mimimimichel/Joey/tools/joey-pilot/rapports/campagne-2026-10-24-soir/droit-apres.jpg

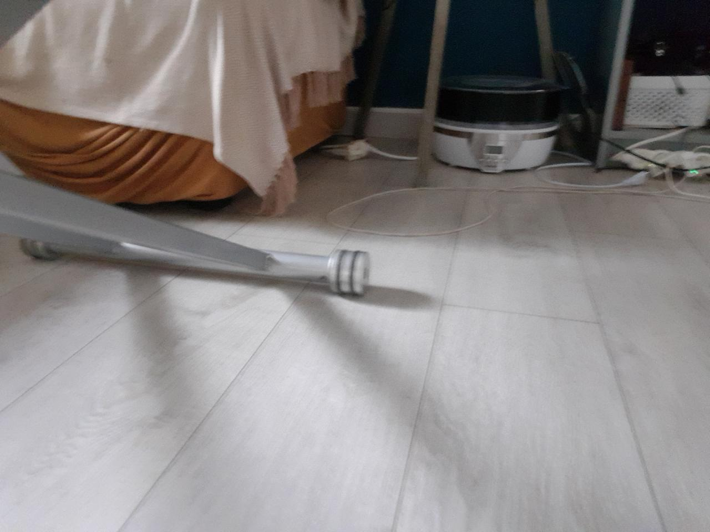
tools/joey-pilot/rapports/campagne-2026-10-24-soir/droit-apres.jpg
