mimimimichel/Joey/tools/joey-pilot/rapports/2026-10-24-1450.md

# Séance du 24/10/2026, midi à 14 h 50 (v0.72 à v0.78)

Téléphone : S8+ (SM-G955F) jusqu'à 14 h 28, puis batterie vide. Suite des essais sur le S10 (SM-G973F).

## Validé sur le robot

- Détecteurs de proximité du Roomba 616 (paquets 45 à 51) : ils marchent. La main à 5 cm fait monter les valeurs.
- Liaison série en 5 V (et non 3,3 V) : plus de coupure au repos sur la base.
- Réouverture automatique du port USB après une coupure : marche (essai toutes les 10 s, 30 fois).
- Accostage par le Roomba lui-même : réussi une fois.
- Pastilles blanches du corps : visibles de -50° à -70° d'inclinaison de la tête. Sur les images de test, l'angle
  tête/corps est mesuré à 8° près environ.

## Problèmes vus, et corrections

| Problème | Correction | Version |
|---|---|---|
| Une commande tronquée lançait l'aspiration « spot » | reprise de contrôle (start, safe, moteurs coupés) | 0.72 |
| Faux appui sur le bouton DOCK | anti-rebond (deux lectures), ignoré en mode test | 0.76 |
| Aligner la tête en bougeant la nacelle oscillait (dépassements) | c'est le corps qui tourne vers la tête | 0.76 |
| Pastilles hors de vue quand la tête est loin de l'axe | recherche en tournant le corps de 60° | 0.77 |
| Liaison morte 8 s sans réponse | réouverture du port USB | 0.77 |
| Point d'approche de la base du mauvais côté | signe corrigé | 0.70 |

## Encore à valider sur le robot

- Alignement tête/corps par les pastilles avec le corps qui tourne (0.77) : pas essayé, le S8+ s'est éteint juste avant.
- La liaison se coupe encore au moment où le Roomba quitte sa base (piste : faux contact du câble mini-DIN).
- Le fil de réveil (BRC, broche 5) ne réveille pas le Roomba.
- Profondeur MiDaS en roulant, passage entre deux chaises, `cmd scan` et `cmd carto`, accostage vérifié, mode autonome.

## Nouveau en 0.78

- Yeux pixelisés : `cmd pixels n=56` (défaut), `n=0` pour des yeux lisses.
- Appui sur l'écran : il lève la tête vers la personne avec un petit sursaut, les roues restent immobiles, et il ne
  part pas en sortie autonome pendant 2 minutes.

## Passage sur le S10

- Joey 0.78 installé (il avait la 0.64), Bluetooth rallumé (il était coupé), adb sur le port fixe 5555.
- `JOEY_PHONE=192.168.0.27:5555,192.168.0.41:5555` dans `~/.config/joey/env` : le pilote vise le S10.
- Mode autonome coupé pour les essais.
- À refaire sur le S10 : test des roues, alignement par les pastilles, carte (la carte du salon est sur le S8+).

## Suite, 15 h à 17 h (v0.79 à v0.83, S10 puis S8)

### Trouvé et corrigé
- **Coupures à la sortie de base (cause trouvée)** : ce Roomba (firmware release-stm32v2-v3.9.7) annonce son mode avec
  un cran de plus que la norme (passif 2, sécurité 3, complet 4). Le décodeur rejetait « complet = 4 » comme du bruit :
  la liaison paraissait coupée à chaque sortie de base. Décalage mesuré à la connexion (0.80). Sortie de base en mode
  complet validée sur le robot (15 h 29), accostage validé (10 s depuis 30 cm).
- **Mélodies** : écrire une mélodie rend le Roomba muet ~2 s. Plus jamais en roulant, une toutes les 4 s au plus (0.83).
- **Alignement par les pastilles** : il tournait pour chercher les pastilles après une bonne mesure, ~600° au bord du
  tapis (tapis embarqué). Rotation bornée à 240°, recherche par la tête d'abord (0.81, 0.83).
- **Détecteur de pastilles et S10** : la caméra du S10 est à ~10 cm de l'axe de la nacelle. Les anciens critères
  (droite des pastilles sous la caméra, une seule pastille) donnaient de fausses mesures sur les reflets du mât et les
  fils. Nouveau critère par la forme (pastille de l'anneau allongée en travers de l'axe, bord du Roomba juste après la
  pastille avant, blanc franc). Hors ligne sur 18 images : 5 vraies mesures cohérentes avec les rotations de la nacelle
  (à 2° près), 0 fausse mesure. À valider sur le robot.
- **Relecture indépendante** (9 agents) : octet 7 (ordre reset) dans la requête des capteurs, retiré (lecture par le
  groupe 7-16) ; mur virtuel 162 confondu avec la base ; impulsion de réveil hors de la boucle des capteurs ; recul hors
  de la base arrêtable ; script d'installation (adb avalait la liste des téléphones, double installation).
- Suite complète des tests : 178 tests verts sur la 0.81.

### Fil de réveil
- Câblage confirmé par Michael (RTS -> trou 5). Firmware assez récent pour le réveil sur la base. `cmd brc` (0.82)
  tranchera : trois impulsions après un redémarrage doivent le faire passer à 19 200 bauds.

### En attente
- Le S10 a redémarré vers 16 h 20 (cause inconnue) ; Michael a remis le S8 sur le robot (Joey 0.77, pas d'adb).
- À faire sur le robot avec la 0.83 : `cmd brc`, alignement par les pastilles sur le parquet, puis MiDaS, `cmd scan`,
  `cmd carto`, accostage depuis plus loin, mode autonome.

## Soirée, 17 h 30 à 19 h (v0.85 à v0.92, S8, campagnes scriptées)

Méthode nouvelle (demande de Michael) : `campagne.py` enchaîne les essais et enregistre tout
(`rapports/campagne-2026-10-24-soir-*`), `garde.py` arrête tout si le câble dépasse 160° ou si la batterie du
téléphone passe sous 25 %, `attendre_et_lancer.sh` démarre une série dès que la batterie et le Roomba sont prêts.

### Validé sur le robot
- **Alignement par les pastilles** (S8, caméra décalée, détecteur par la forme) : 3 sur 3, en une rotation chacun
  (+61° -> -1°, -24° -> 0°, +72° -> +1°) ; images d'après alignement : la tête regarde l'avant.
- Nacelle verrouillée (la tête reste fixe quand le corps tourne de 45°) ; ligne droite 50 cm aller-retour ; 4 rotations
  de ±90° ; tour d'horizon (12 images, 366 bords).
- **Fil de réveil (BRC) : il marche** (3 impulsions après redémarrage -> 19 200 bauds) ; câblage bon.
- **Sortie de base après une longue charge** : moteurs coupés par le Roomba (voyant CLEAN allumé, aucun bruit) ;
  un redémarrage logiciel (ordre « reset ») les rallume, et la sortie passe (18 h 41).
- Déroulement automatique du câble (« je tourne la tête de 100° pour le dérouler »).

### Corrigé
- Bips de la reconnaissance vocale en boucle (flux des notifications, coupure refusée par Samsung) : volume à 0, et pas
  d'écoute en mode test (0.85).
- Mode test : la tête ne bouge que sur ordre (plus de coups d'œil ni d'initiatives) (0.85).
- Le câble n'était pas compté tête baissée (seuil 70° -> 85°) : le compteur dérivait à chaque recalage (0.86).
- Analyse du sol coupée tête baissée (le capot vu comme « toilettes à -5 cm » bouchait la carte) (0.86).
- Recalage seulement sans repère ou après 5 min (il se recalait après chaque choc) (0.86).
- Demi-tour quand il est bloqué de face ou au 3e essai (demande de Michael) (0.87).
- Zéro du câble à la connexion de la nacelle ; la tête suit le corps pendant l'accostage et les trajets (0.89).
- Sortie de base : redémarrage du Roomba en dernier recours, sans fausse alerte de liaison (0.90, 0.91).
- Caméra ralentie à l'arrêt en mode test (le S8 perdait ~35 %/h) (0.92).

### Nouveau matériel proposé
- `hardware/repere-corps/fleche_v2.stl` (flèche 60 × 24 mm) et `anneau.stl` (anneau Ø 180-228 mm d'un seul tenant,
  symbole différent à chaque point cardinal). Détecteur de l'anneau prêt (`cmd anneau on=1`), validé sur images de
  synthèse (12 orientations sur 12, erreur ≤ 8° avec un montage approximatif).

### Reste à valider sur le robot
- Accostage avec la tête qui suit le corps (0.89) ; sortie de base avec le redémarrage intégré (0.91) ; cartographie ;
  mode autonome 8 min. Série prête, elle part seule à 50 % de batterie avec le Roomba branché.
- Alimentation du téléphone pendant les essais (hub USB-C avec recharge, ou depuis la batterie du Roomba).

### 20 h 15 (v0.94 à v0.97)
- Série 9 : nacelle verrouillée ; alignement 3 sur 3 (+39 -> -4, +31 -> -1, +70 -> +1), câble entre -7° et 0° ;
  exploration 1 m (+6 m²) puis retour « arrivé » ; accostage interrompu par le garde-fou (câble +195° : le Roomba tourne
  plus vite que la nacelle en cherchant sa base) mais fini seul ensuite.
- Corrigé : écran rallumé au démarrage et quand la caméra ne voit plus rien (0.95, vu marcher) ; demi-tour dans le sens
  qui déroule le câble (0.96) ; accostage en pause au-delà de 140° de torsion (0.97) ; plus de recalcul sans fin du même
  chemin (25 fois en 50 s) (0.97).
- Joey arrêté à 20 h 25 sur sa base, en charge, mode autonome coupé.
