mimimimichel/Joey/hardware/apriltags/repere-corps-joey.pdf

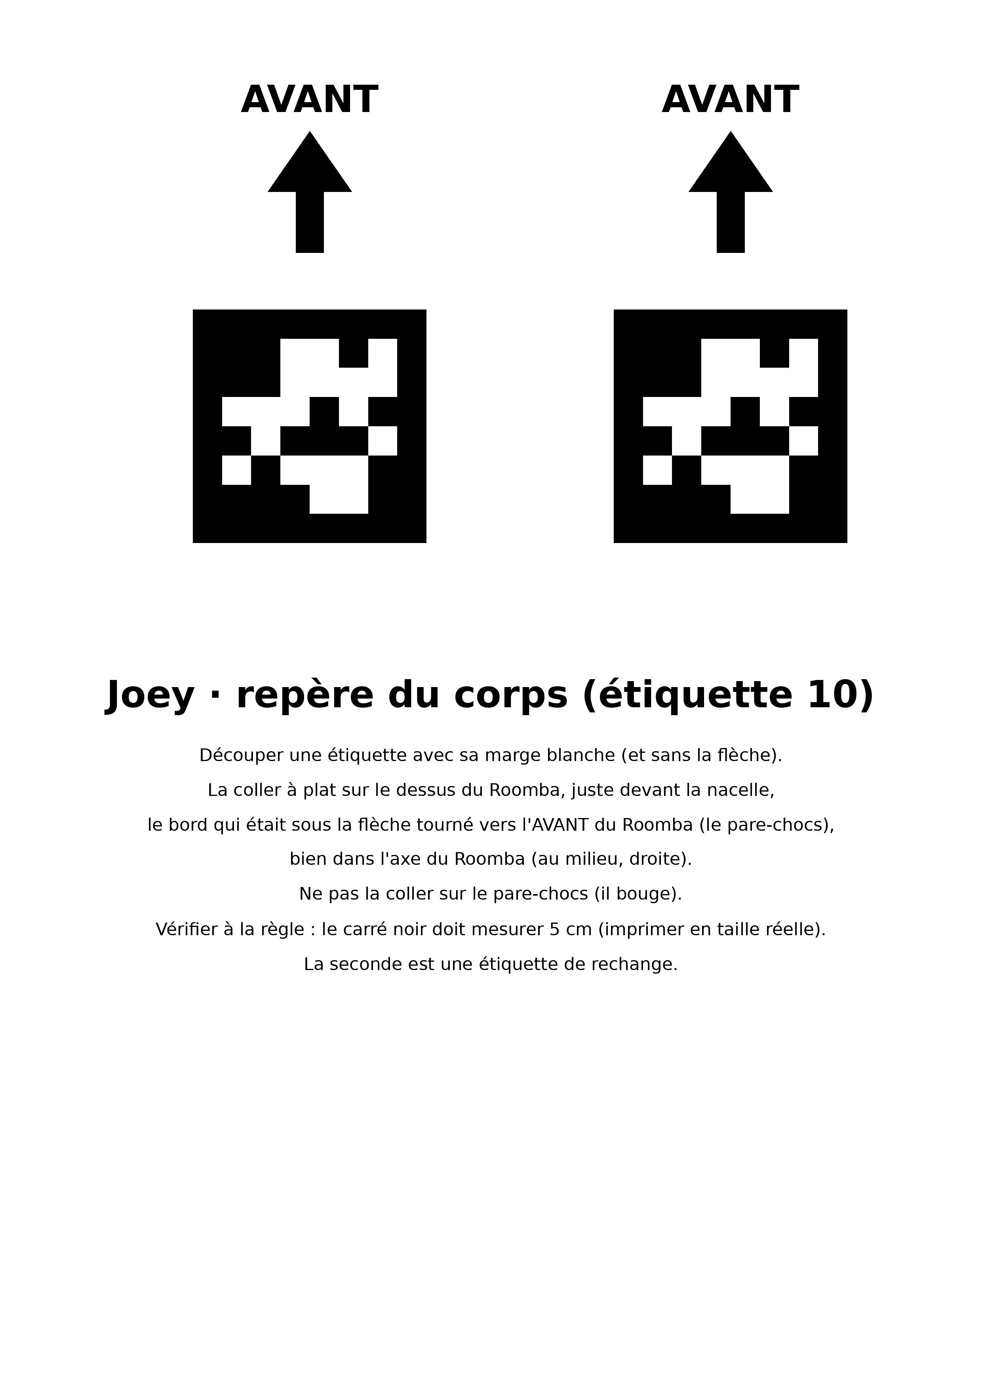
[picture p3: page 1]
