mimimimichel/Joey/hardware/repere-corps/apercu.png

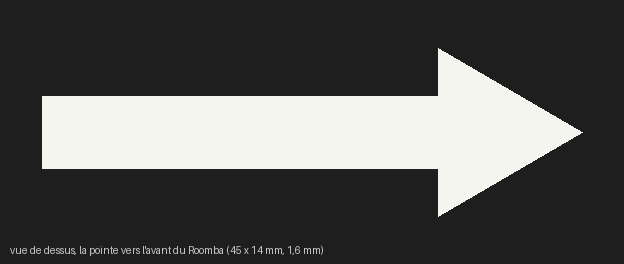
hardware/repere-corps/apercu.png
