mimimimichel/Joey/hardware/repere-corps/apercu_anneau.png

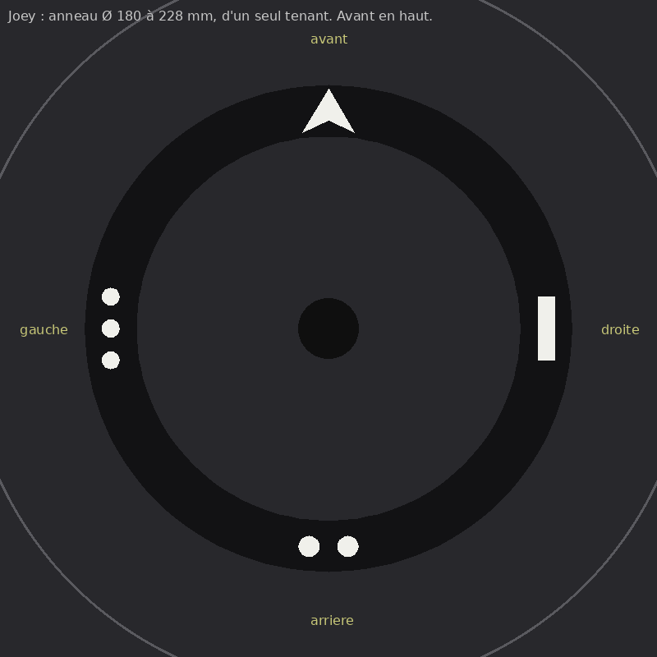
hardware/repere-corps/apercu_anneau.png
