mimimimichel/Joey/hardware/repere-corps/apercu_v2.png

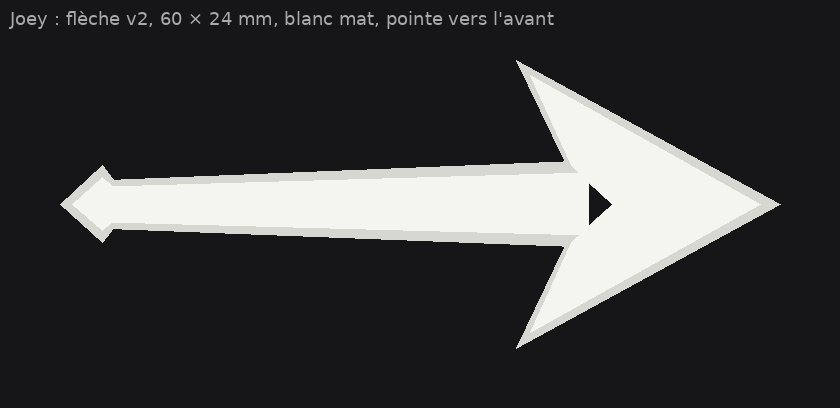
hardware/repere-corps/apercu_v2.png
