mimimimichel/Joey/tools/joey-pilot/rapports/campagne-2026-10-24-soir-9/alignement-2.jpg

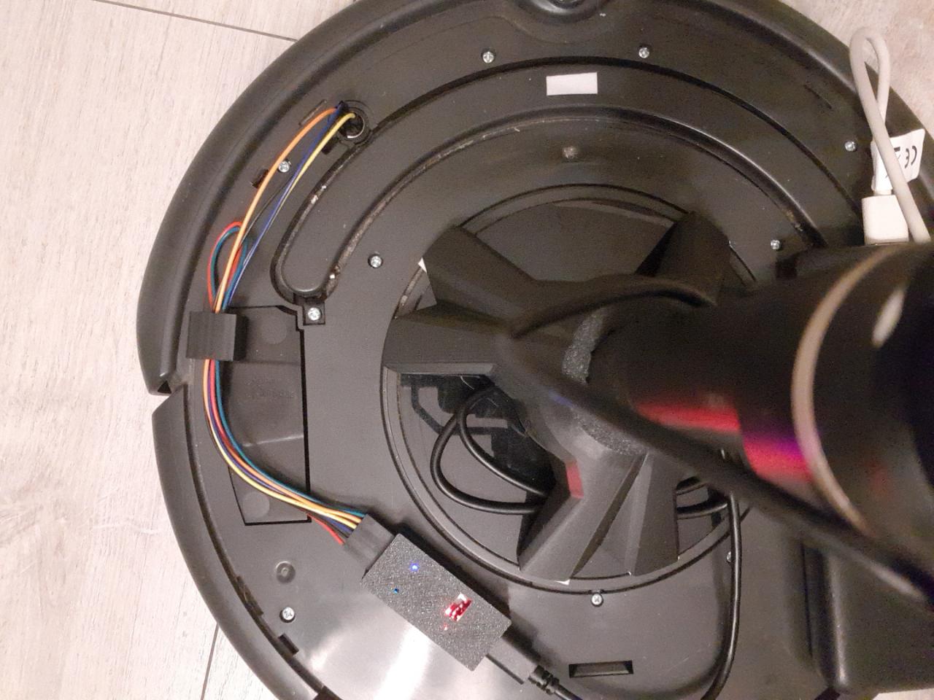
tools/joey-pilot/rapports/campagne-2026-10-24-soir-9/alignement-2.jpg
