mimimimichel/Joey/tools/joey-pilot/rapports/campagne-2026-10-24-soir/alignement-2.jpg

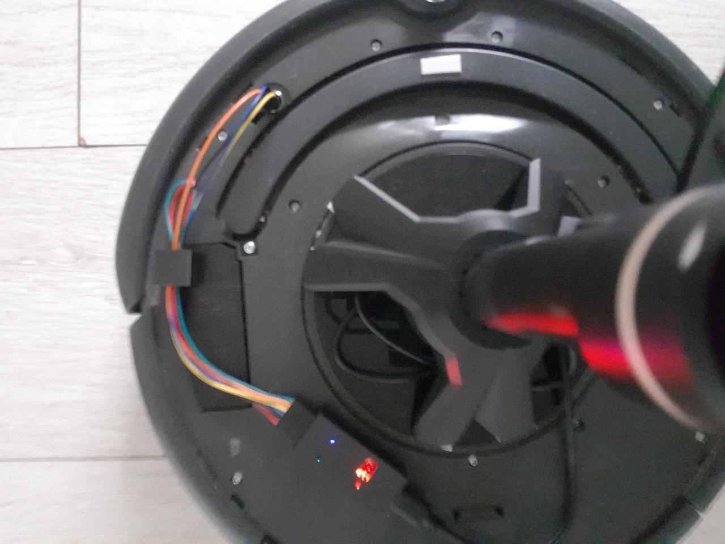
tools/joey-pilot/rapports/campagne-2026-10-24-soir/alignement-2.jpg
