mimimimichel/Joey/tools/joey-pilot/rapports/campagne-2026-10-24-soir/droit-avant.jpg

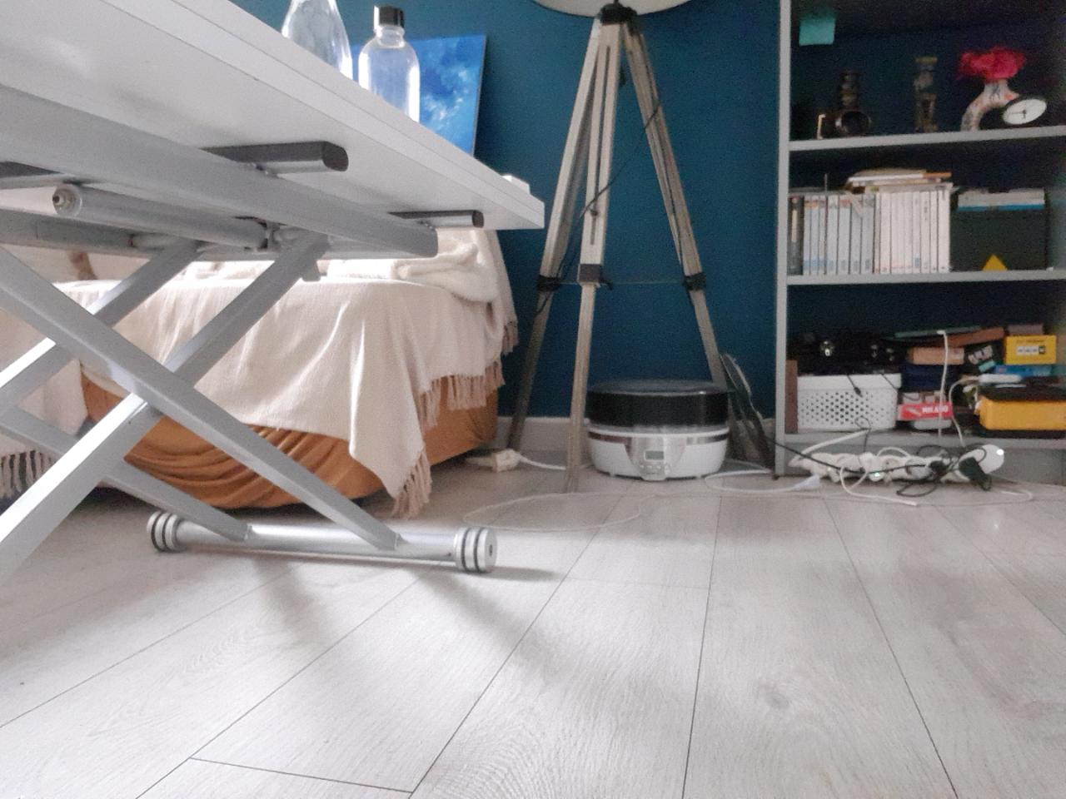
tools/joey-pilot/rapports/campagne-2026-10-24-soir/droit-avant.jpg
