mimimimichel/Joey/tools/joey-pilot/rapports/campagne-2026-10-24-soir/droit-retour.jpg

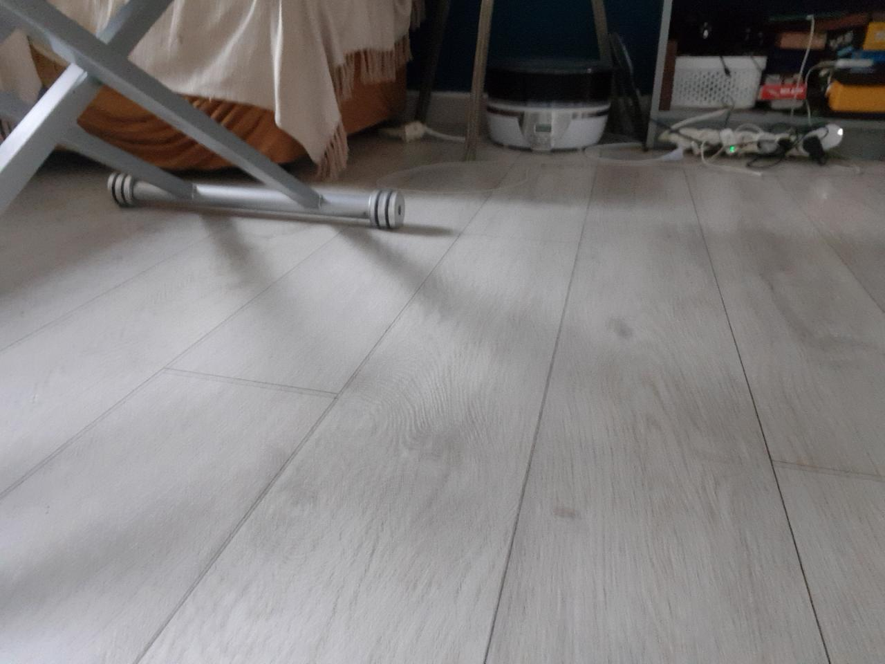
tools/joey-pilot/rapports/campagne-2026-10-24-soir/droit-retour.jpg
