mimimimichel/Joey/tools/joey-pilot/rapports/campagne-2026-10-24-soir/pastilles-10.jpg

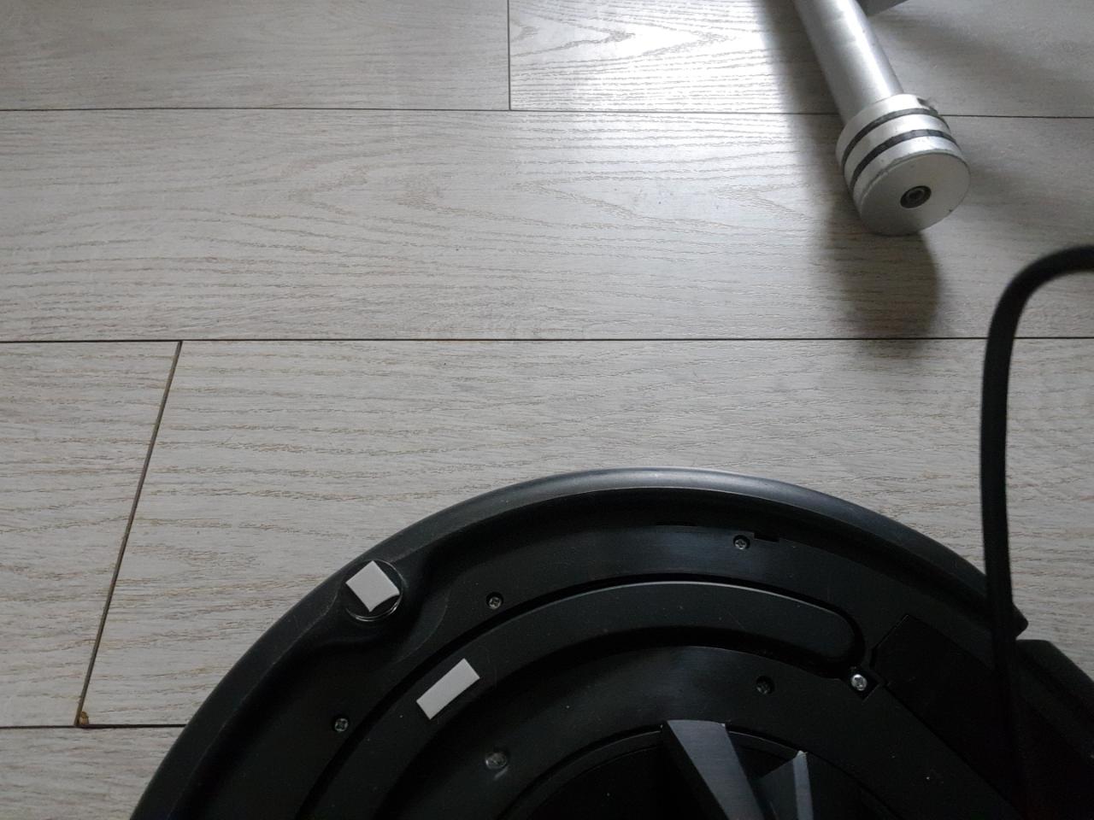
tools/joey-pilot/rapports/campagne-2026-10-24-soir/pastilles-10.jpg
