mimimimichel/Joey/tools/joey-pilot/rapports/campagne-2026-10-24-soir/rot-0.jpg

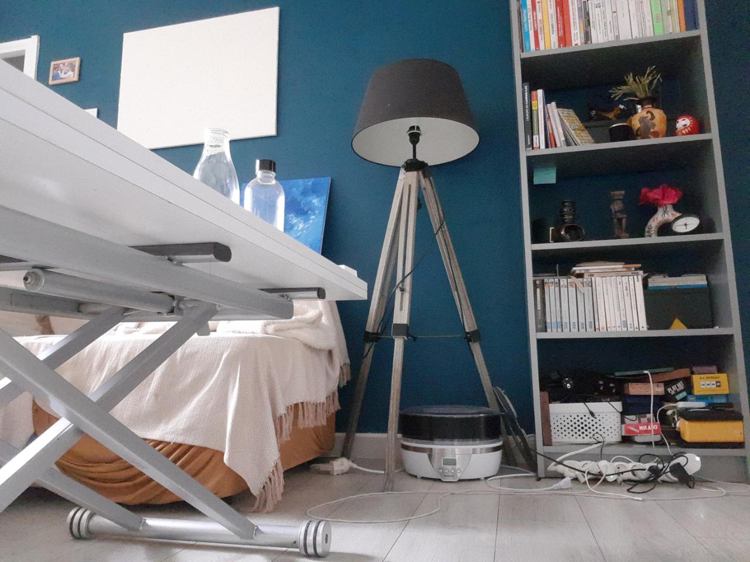
tools/joey-pilot/rapports/campagne-2026-10-24-soir/rot-0.jpg
