mimimimichel/Joey/tools/joey-pilot/rapports/campagne-2026-10-24-soir/rot-fin.jpg

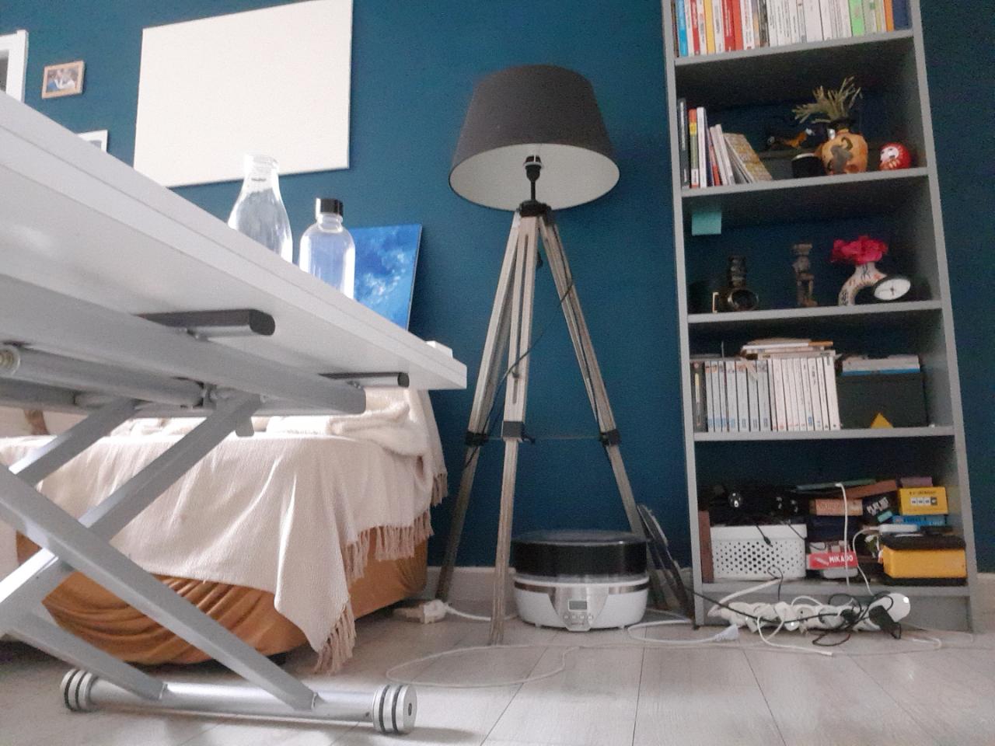
tools/joey-pilot/rapports/campagne-2026-10-24-soir/rot-fin.jpg
