mimimimichel/Joey/hardware/repere-corps/anneau.stl

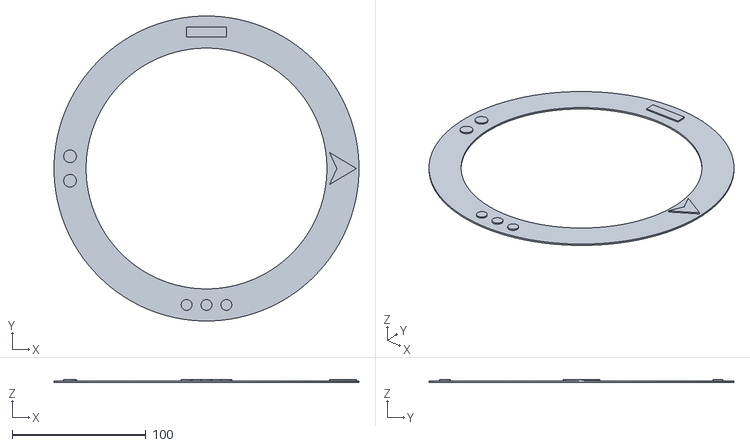
[picture p28: CAD file, 2026-10-24]
hardware/repere-corps/anneau.stl
228.0 x 228.0 x 2.20
