mimimimichel/Joey/hardware/roomba-mount/roomba_mount.stl

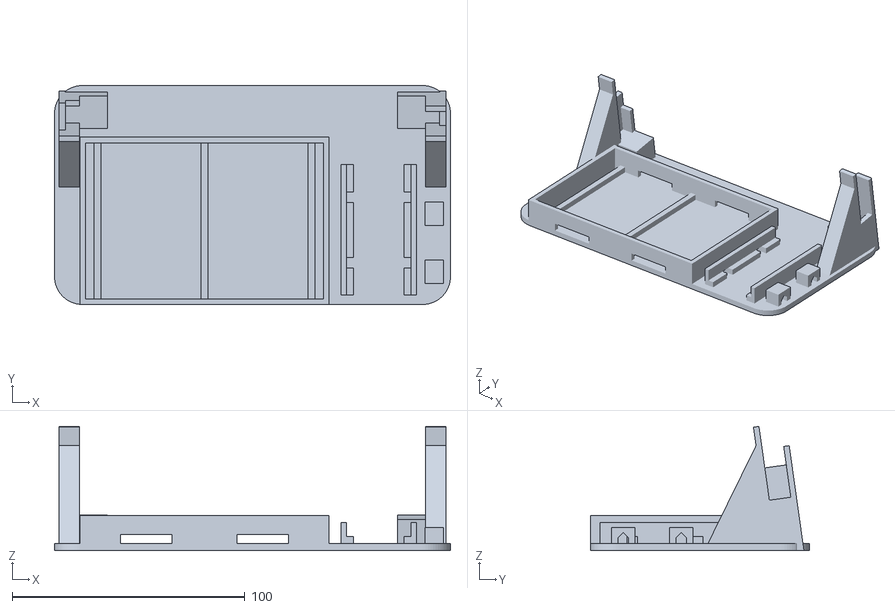
[picture p29: CAD file, 2026-10-21]
hardware/roomba-mount/roomba_mount.stl
170.0 x 94.0 x 53.3
