mimimimichel/Joey/hardware/repere-corps/fleche_v2.stl

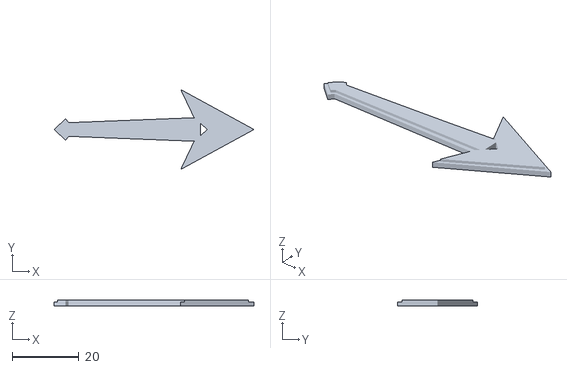
[picture p30: CAD file, 2026-10-24]
hardware/repere-corps/fleche_v2.stl
60.0 x 24.0 x 1.80
