mimimimichel/Joey/hardware/repere-corps/fleche.stl

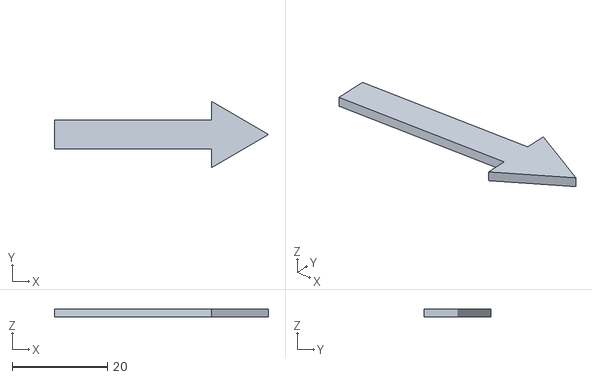
[picture p31: CAD file, 2026-10-24, an earlier design]
hardware/repere-corps/fleche.stl
45.0 x 14.0 x 1.60
