mimimimichel/Joey/(list of files, cad)

Other CAD files:
hardware/roomba-mount/roomba_mount.scad
