mimimimichel/Joey/(commit log)

2026-10-21 Démarrage du projet Joey : brief, matériel, personnalité, code Roomba et vision repris du projet drone, support 3D
    Claude-Session: https://claude.ai/code/session_01JXq4H1NqX7VkUUWKoh8E1F
    [roomba_mount.scad, roomba_mount.stl]
2026-10-21 Nacelle Feiyu SPG : devient le cou de Joey (pilotage Bluetooth à décoder, procédure d'enregistrement, montage)
    Claude-Session: https://claude.ai/code/session_012MrQctv3qeyW7PFJ4WLDpC
2026-10-21 App Joey 0.1 : visage animé, conversation Gemini Live avec voix de robot, tête sur la nacelle SPG
    - Visage plein écran (yeux, expressions, regard, bouche qui suit la voix)
    - Gemini Live repris de Bebop IA (voix de robot), personnalité de Joey, outils :
    regarder, regarder_autour, exprimer (oui/non/hésiter), retenir, etat
    - Nacelle SPG en BLE : connexion auto (FY_Spg_*), joystick 20 Hz, angles, batterie
    - Tête en boucle fermée sur les angles (repli à l'aveugle), panneau manuel avec joystick et journal
    - Caméra sans aperçu (1 image/s pour Gemini), mémoire persistante, rapport de plantage
    - Tests : protocole contre la capture réelle, tête sur fausse nacelle, lancement (Robolectric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
2026-10-21 Joey 0.2 : la tête suit le visage (ML Kit sur le téléphone), les yeux regardent la personne
    - Détection de visage ~10 images/s sur la caméra avant, sans Internet
    - Suivi en boucle sur l'image ; sens gauche/droite et haut/bas trouvés tout seuls (et retenus)
    - Pause du suivi pendant les mouvements demandés par Joey ou à la main
    - Réglage « Suivre mon visage », pastille « Je te vois »
    - APK limité aux processeurs ARM 64 bits (24 Mo au lieu de 49)
    - Détecteur créé à la première image (le test de lancement plantait sinon)
    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
2026-10-21 Joey 0.3 : réponses rapides, tête beaucoup plus vive et sans limite
    - Gestes (oui/non/hésiter) en arrière-plan : Joey parle pendant que la tête bouge
    (avant, il attendait la fin du geste pour répondre : c'était la lenteur)
    - Un seul mouvement à la fois, le plus récent annule le précédent
    - Vitesse de la tête réglable (Douce 314 / Vive 500 / Rapide 700 / Max 1000), freinage dans les 25 derniers degrés
    - Repli automatique à 314 si la nacelle ignore les grandes valeurs ; vitesse réelle mesurée dans le journal
    - Inclinaison de -90 à +90, nouvelle direction « derrière » ; le prompt dit que la tête tourne sur 360° sans limite
    - Suivi du visage plus rapide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
2026-10-21 Joey 0.4 : haut/bas corrects avec la caméra avant, Joey cherche la personne du regard
    - La nacelle raisonne pour la caméra arrière : avec la caméra avant, haut et bas sont inversés (gauche/droite non)
    - Nouvel outil chercher_personne : là où il regarde, puis 360° en deux hauteurs, s'arrête dès qu'un visage est vu
    et laisse le suivi le centrer
    - Recherche automatique quand on lui parle et qu'il ne voit personne (au plus toutes les 20 s)
    - regarder renvoie si un visage est dans l'image ; prompt : ne jamais dire « je ne te vois pas » sans chercher
    - Yeux : regard vers la gauche de l'écran quand il tourne à sa droite
    Claude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
    [HeadTest.kt, JoeyPrompt.kt]
2026-10-21 Joey 0.5 : « cherche le chien » — détecteur d'objets sur le téléphone + vision Gemini
    - Détecteur MediaPipe EfficientDet-Lite2 (80 catégories COCO, noms français) repris de Bebop IA
    - Outil chercher(objet) : fait le tour du regard (360°, deux hauteurs) ; catégorie connue -> détecteur
    à chaque image, la tête se tourne vers l'objet et le suit (15 s) ; sinon Gemini Vision à chaque arrêt
    (Robotics-ER puis Flash) et centrage sur la boîte trouvée
    - « Cherche-moi » : détection du corps (personne) puis suivi du visage ; aussi la recherche automatique
    - regarder_autour renvoie ce que le détecteur reconnaît à chaque arrêt
    - Pastille « 🔎 chien » pendant la recherche /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
2026-10-21 Joey 0.6 : la tête va au bout de ses mouvements, vraie recherche à 360°, la pizza
    - Mesure de la vitesse réelle de la tête (6 valeurs du joystick) à la première connexion + bouton ;
    on garde la plus rapide, le réglage de vitesse devient un % de cette vitesse
    - Délais des mouvements calculés selon l'angle et la vitesse mesurée (avant : 3-6 s fixes, coupés en route)
    - Freinage selon la vitesse ; « tourne de 90° » va au bout
    - Recherche : tour complet en continu pendant l'analyse des images (à hauteur des yeux, puis plus bas)
    - Détecteur : nourriture et objets de cuisine ajoutés (pizza, banane, gâteau, couverts…)
    - Prompt : parler en accord avec les mouvements, angle dema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
    [HeadTest.kt, JoeyPrompt.kt]
2026-10-21 Joey 0.7 : capteurs du téléphone pour diriger la tête, vue et pilotage depuis un casque Quest
    - Orientation par les capteurs du téléphone (gyroscope + accéléromètre, sans aimant) : cap et élévation de la
    caméra qui regarde, ~100 mesures/s ; la mesure de la tête apprend aussi le sens du joystick (droite, haut)
    -> plus d'erreur de sens. Repli sur les angles de la nacelle sans capteur. Boussole donnée à Joey (info).
    - Casque Quest (repris du cockpit de Bebop IA) : https://<téléphone>:8443, vidéo de la caméra, VR où la nacelle
    suit la tête (gâchette = devant, grip = suivi on/off, manche droit = joystick, A = parler, B = cherche-moi),
    conversation par le micro et le s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
2026-10-21 Joey 0.8 : tête bien plus rapide (mesure jusqu'à 6500), sens mesurés, suivi du visage stable
    D'après le journal du 2026-10-21 : la vitesse monte en ligne droite avec le joystick (1000 -> 29°/s) sans plafond.
    - Joystick accepté jusqu'à ±8000 ; mesure de 300 à 6500, on garde la plus rapide qui marche
    - Sens haut/bas mesuré avec un vrai mouvement (avant : ~2°, trop faible)
    - Mesure lancée une seule fois à la connexion (elle s'interrompait elle-même) ; refaite si la version de mesure change
    - Suivi du visage : vitesse en °/s d'après la mesure, preuve plus nette avant d'inverser le sens,
    inversion aussi quand le visage sort de l'image en s'éloignant, et poursuite vers où il a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
2026-10-21 Joey 0.9 : conversation rapide dans la durée, plus de faux « trouvé », coups d'œil utiles
    - Gemini Live : images en basse résolution, une image toutes les 2 s, résumé du contexte dès ~25 000 jetons
    (avant : réponses de plus en plus lentes, ~10 s au bout d'une minute) ; réglages vérifiés sur les 3 modèles
    - Cible crue après 2 images de suite et un score suffisant ; visage trop petit ignoré
    - chercher : vérification une fois la tête tournée ; sinon « fausse alerte » dite honnêtement
    - Recherche automatique seulement si personne n'est vu depuis 8 s (la tête bougeait « toute seule »)
    - Prompt : petit coup d'œil (10-30°) quand il manque du contexte ; honnêteté sur c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
2026-10-21 Joey 0.10 : une vraie mémoire sur le téléphone
    - Souvenirs automatiques : toutes les 2 min et à la fin de chaque conversation, Gemini relit ce qui a été dit
    et en tire les faits durables (prénoms, goûts, habitudes, où sont les choses, projets, dates réelles)
    - Pas de doublons (même chose dite autrement), jusqu'à 1000 souvenirs, écriture sûre du fichier
    - Outils se_souvenir (cherche dans toute la mémoire) et oublier ; prompt : retenir activement, chercher avant
    de dire « je ne sais pas »
    - Réglages : « Voir ses souvenirs » (liste, ✕ pour en effacer un)
    - Tests : recherche, doublons, oubli, relecture du fichier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
2026-10-21 Joey 0.11 : il reconnaît les gens de la maison, voit plus loin, regarde de près
    - Caméra en 1280x960 (au lieu de 640x480) : visages détectés jusqu'à ~3-4 m (taille mini abaissée)
    - regarder_de_pres : recadrage haute définition envoyé à Gemini Vision (lire un texte, détail, quelqu'un au fond) ;
    la conversation garde ses images légères
    - Reconnaissance des visages sur le téléphone (MobileFaceNet) : apprendre_visage / oublier_visage (outils et réglages),
    empreintes seulement, seuil 0,50 mesuré sur LFW, deux reconnaissances de suite ; salut par le prénom
    (au début de la conversation et quand quelqu'un apparaît, au plus toutes les 20 min)
    - Pastille « 👤 Prénom », r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
2026-10-21 Joey 0.12 : mot de réveil, recherche Google, photographe, danse, vie propre, mode garde
    - « Joey » : reconnaissance vocale du téléphone en boucle (sur l'appareil si possible), conversation lancée sans
    bouton, finie seule après 45 s de silence
    - Recherche Google dans Gemini Live (testée : météo de Toulouse) ; quota épuisé -> modèle suivant au lieu d'arrêter
    - prendre_photo : ImageCapture pleine définition, compte à rebours sur le visage, flash, galerie Images/Joey
    - danser : détecteur de temps forts sur le micro de la conversation (testé à 120 BPM), hochement + balancement
    - Vie propre : mouvement dans l'image -> coup d'œil, ennui, sommeil après 10 min, réveil
    - Mode g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
2026-10-21 Joey 0.13 : carte de la maison avec Gemini Robotics-ER
    - cartographier(lieu) : tour du regard en 6 arrêts ; Robotics-ER (repli Flash) donne le type de pièce, une description,
    et pointe jusqu'à 15 éléments avec leur distance ; placés au cap boussole (boussole du départ + rotation mesurée)
    - ou_est(objet) : cherche sur la carte (puis dans la mémoire) ; tête tournée vers l'objet si c'est la pièce actuelle
    - ou_suis_je : Robotics-ER compare la vue aux lieux relevés ; carte : résumé pour Gemini
    - HouseMap sur le téléphone, positions (x, y) prévues pour l'odométrie du Roomba ; réglages « Voir sa carte »
    - Appel Robotics-ER vérifié (schéma, points, distances)
    Co-Authored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
2026-10-22 Roomba : roues de Joey (pilote autonome repris de Bebop IA), viens ici, suis-moi, aller à un lieu, base, mélodies
    - RoombaRobot sans dépendance au drone : mode sécurité, odométrie, pare-chocs, sortie de base, goTo, vitesses continues
    - 8 tests sur faux Roomba (115200/57600, 50 cm, 90°, point, pare-chocs, vide, sortie de base)
    - Outils avancer, tourner_corps, viens_ici (cherche, s'aligne, s'approche à ~1 m), suis_moi, arrete, aller_a, rentrer_base
    - Émotions -> mélodies et couleur du bouton CLEAN ; oui/non/hésiter avec bips
    - Carte : position (x, y) des lieux relevés avec les roues ; carte USB branchée -> connexion automatique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
2026-10-22 Rappels, batteries, nuit, journal du jour, gestes et doigt pointé, toucher et secousses, jeux
    - Rappels/minuteurs (outils rappel/rappels/annuler_rappel), dits à voix haute (conversation démarrée exprès) + ntfy
    - Batteries téléphone/nacelle/Roomba surveillées, retour à la base si les roues faiblissent ; mode nuit 23 h-7 h
    - Journal du jour à 21 h 30 écrit par Gemini, envoyé avec une photo (outil journal_du_jour)
    - Gestes (MediaPipe) : pouce, V, coucou (réveille la conversation), doigt pointé -> la tête se tourne ; 5 tests
    - Toucher : appui, double appui = chatouilles, appui long ou caresse ; secousse -> yeux en spirale
    - Jeux : pierre-feuille-ciseaux (lit la main, affiche son c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
2026-10-22 Joey 0.14 : voix apprises, maison connectée (Home Assistant), les 10 améliorations
    - Voix : référence de 6 s par personne (sur le téléphone), parole récente gardée en anneau, comparaison par Gemini
    (requête vérifiée ; résultat approximatif -> prudence sous 0,7)
    - Home Assistant : adresse + jeton dans les réglages, outils maison_appareils / maison_commande
    (allumer, éteindre, basculer, ouvrir, fermer, régler), correspondance des noms testée
    - README : récapitulatif
    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
2026-10-22 v0.15 : Joey cherche mieux quand on l'appelle
    - Cherche tout de suite en entendant « Joey » s'il ne voit personne
    - Regarde d'abord là où il a vu la personne en dernier
    - Devine gauche/droite avec les deux micros (et apprend le câblage tout seul)
    - S'approche avec le Roomba si la personne est loin
    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
2026-10-22 v0.16 : garde-fou contre les plantages au lancement
    - Gestes et posture sur le processeur (plus trois modèles sur la carte graphique à la fois)
    - Chaque chargement de modèle est surveillé : s'il tue l'app, il est sauté au lancement suivant
    - Le rapport affiché au lancement dit quelle étape a planté (même sans trace Java)
    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
2026-10-22 v0.17 : le rapport de plantage s'affiche seul, avant de démarrer Joey
    Avant, Joey démarrait puis montrait le rapport : s'il replantait au démarrage,
    le rapport n'apparaissait jamais. La surveillance démarre maintenant dès
    l'application (JoeyApp), et l'écran du rapport passe avant tout le reste.
    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
2026-10-22 v0.18 : corrige le plantage au lancement (mot de réveil)
    L'option (?U) de l'expression « Joey » n'existe pas dans le moteur d'Android
    (ICU) : PatternSyntaxException dès la création du ViewModel. Le mot est
    maintenant encadré par des lookarounds, avec une liste de secours si jamais
    l'expression ne compile pas.
    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
2026-10-22 v0.20 : suivi en degrés, plus de faux « je te vois », regard pendant la conversation
    - Image redressée d'après la pesanteur (et non le sens de l'écran) : avec la
    rotation auto coupée et le téléphone couché sur la nacelle, l'image était de
    travers et le suivi tournait dans le mauvais sens
    - La tête vise en degrés : cap au moment de l'image + écart de la cible (champ
    de vision réel de l'objectif), plus de sens deviné en regardant l'image bouger
    - Un petit visage n'est cru que si le détecteur voit aussi une personne autour
    - En conversation, il revient vers la personne s'il ne la voit plus depuis 2,5 s
    - Gemini reçoit « [Capteurs] » quand la caméra voit ou ne voit plu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
2026-10-22 v0.21 : Gemini Robotics-ER pour chercher, vérifier, comprendre le doigt pointé, aller vers
    - Chercher : le détecteur du téléphone d'abord, puis Gemini Robotics-ER s'il ne
    trouve pas (arrêts plus serrés que le champ de la caméra, point + distance) ;
    la tête se tourne pile sur l'objet
    - Vérifier : un objet trouvé par le détecteur est confirmé par Robotics-ER une
    fois la tête centrée (sinon « fausse alerte ») ; une silhouette sans visage
    aussi
    - Doigt pointé (geste vu ou outil regarder_ce_que_je_montre) : Robotics-ER suit
    le bras, dit ce qui est montré et où ; la tête y va
    - aller_vers : Robotics-ER repère le sol devant la chose et sa distance, le
    Roomba avance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
2026-10-22 v0.22 : il répond pendant qu'il cherche, recherche méthodique
    - Outils longs (chercher, aller_vers, viens_ici, cartographier, ce que je
    montre) en arrière-plan : Gemini n'attend plus jusqu'à une minute sans
    pouvoir répondre ; le résultat lui arrive ensuite, sans couper la parole
    - Retire les messages [Capteurs] (tour « non terminé » : ~2 s de retard sur
    la réponse suivante, mesuré)
    - Recherche Robotics-ER : un tour dans un seul sens par hauteur (au lieu de
    gauche-droite en alternance), analyse de l'arrêt précédent pendant que la
    tête passe au suivant ; arrêts du détecteur raccourcis (0,5 s)
    Claude-Session: ht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
2026-10-22 v0.23 : plusieurs personnes, il regarde bien en face celle qui parle
    - Tous les visages sont suivis (numéro ML Kit, repères nez/bouche)
    - Quand on entend une voix, il se tourne vers le visage dont la bouche bouge
    nettement plus (0,6 s de suite, au moins 1,5 s sur le précédent) ; sinon il
    garde celui qu'il regarde
    - Outil regarder_personne : prénom, « autre », « gauche », « droite » ; prénom
    inconnu avec deux personnes -> l'autre ; hors de l'image -> là où il l'a vue
    - Prénom mis sur chaque visage visible (un toutes les 0,4 s) et dernier
    endroit où chacun a été vu
    Claude-Session: https://claude.ai/code/session_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
2026-10-22 v0.24 : il regarde tes mains quand tu les bouges, puis revient à ton visage
    - HandAttention : main (poignet + index) qui bouge nettement par rapport au
    nez (la tête de Joey qui tourne ne compte pas), deux analyses de suite ->
    coup d'œil ; vise entre visage et main si les deux tiennent dans l'image
    - Reste sur les mains tant qu'elles bougent + 1,2 s, 5 s au plus, puis au
    moins 2,5 s sur le visage ; mains posées en bas de l'image ignorées
    - Seulement les mains de la personne regardée ; analyse du corps plus
    fréquente pendant le coup d'œil ; Gemini reçoit une image fraîche
    Claude-Session: https://claude.ai/code/session_0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
2026-10-22 v0.25 : plus vivant (10 améliorations) et il sent quand on le soulève
    - Langage du corps (life/Expressive) ajouté au regard : respiration, petits
    hochements sur sa voix et pose qui change à chaque phrase, hochements
    d'écoute, visage penché à l'écran quand il réfléchit ; petites corrections
    en douceur ; la tête tient sa pose (et respire) quand il ne suit personne
    - Les yeux partent vers la cible avant la tête
    - Attention partagée : tête tournée 1,5 s sans parler -> Robotics-ER dit ce
    qu'elle regarde, il regarde aussi, puis revient
    - Il sourit quand on lui sourit (ML Kit, probabilité de sourire)
    - Sursaut aux bruits forts et brefs (micro de la conversation ou du mot de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
    [GeminiVision.kt]
2026-10-22 v0.26 : tête plus vive, plus expressif, la réflexion se voit
    - Loi de vitesse de la tête : vise d'arriver en ~0,18 s, plafonnée à la
    vitesse max ; l'ancienne rampe de freinage rendait lents tous les petits
    mouvements (hochements, corrections). Plus de ralentissement le soir.
    - Langage du corps plus ample : hochements de 7°, pose de ±8° par phrase,
    respiration plus visible
    - Attitude par humeur : bonds de joie, tête basse (triste), recul (étonné),
    « non non » (fâché), regard en coin (méfiant), tête qui tombe (fatigué)…
    - Il réfléchit (on attend sa réponse, il cherche) : tête levée sur le côté,
    regard qui va et vient en l'air, visage penché à 15°, paupi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
2026-10-22 v0.27 : mains déduites des bras, grand angle, export du journal
    - Mains hors de l'image (caméra centrée sur le visage) : position déduite du
    bras (poignet estimé par MediaPipe s'il est cohérent, sinon épaule -> coude
    prolongé) ; plus de filtre « main en bas de l'image » qui ignorait les
    gestes à hauteur de poitrine ; analyse du corps plus fréquente (0,22 s)
    - Caméra : la plus grand angle du côté choisi (si le téléphone en a deux),
    zoom arrière au minimum si l'objectif le permet ; champ réel mesuré
    - Journal de bord sur le téléphone (un fichier par jour, 14 jours) :
    répliques (toi / Joey), outils et résultats avec durées, temps de réponse,
    états de la co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
2026-10-22 v0.28 : il arrête de commenter tout, ne regarde plus le plafond
    - Pose de repos prise SANS les petits mouvements expressifs : avant, à chaque
    reprise il les ajoutait et la tête montait peu à peu vers le plafond ;
    inclinaison de repos limitée à ±35°
    - Pose « je réfléchis » plus discrète (5°), seulement en attendant sa réponse
    - Budget de parole : remarques spontanées seulement en conversation, quand
    personne ne parle, au plus une toutes les 20 à 45 s ; pouces, V, sursaut,
    poussé, reposé : réaction du visage et de la tête, sans paroles
    - Consignes : ne jamais dire ses gestes ni ses expressions, ne pas lire les
    messages de l'application, ne pas commenter ce qu'il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
    [JoeyPrompt.kt]
2026-10-22 v0.29 : plus d'« expression étonnée » à voix haute, plus de faux bruits
    - Outil exprimer retiré (le modèle lisait ses appels à voix haute) : les
    expressions suivent ce qu'il dit (« oh ! » étonné, « haha » amusé,
    « désolé » triste…), et la tête aussi (« oui » hochement, « non » non de la
    tête, « hmm » hésitation)
    - Sursaut beaucoup moins sensible : 28 dB au-dessus du fond, pic au-dessus de
    -16 dBFS, 0,25 s au plus, une fois toutes les 10 s ; seulement en
    conversation, pas pendant qu'il parle ni 2 s après, pas quand sa tête bouge ;
    plus de niveau de la reconnaissance du mot de réveil (il sautait à chaque
    relance) ; interrupteur dans les réglages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
2026-10-22 v0.30 : le journal part dans Supabase pour être analysé au fil de l'eau
    - remote/JournalUpload : chaque ligne du journal (répliques, outils, mesures,
    logs) envoyée par paquets toutes les 30 s dans la table journal du projet
    Supabase « joey » (insertion seulement : la clé publique ne permet pas de
    lire) ; garde jusqu'à 5000 lignes sans Internet
    - Adresse et clé injectées à la compilation (SUPABASE_URL / SUPABASE_KEY),
    jamais dans le dépôt ; identifiant d'appareil aléatoire + modèle
    - Réglage « Envoyer le journal à Claude » (activé)
    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
2026-10-22 v0.31 : corrections d'après le journal (quota, nacelle, chien, lenteurs)
    D'après le journal du 22/10 (19:05-19:12) :
    - Quota Gemini gratuit épuisé (20 requêtes/jour pour Flash) : chaque modèle
    refusé est mis de côté jusqu'à l'heure donnée par Google ; la recherche
    Robotics-ER ne perd plus 30-50 s à réessayer à chaque arrêt ; Joey le dit
    - Vision avancée automatique (regard partagé, nouveautés) désactivée par
    défaut : elle mangeait le quota (réglage pour la remettre)
    - Nacelle : un vieux minuteur de connexion coupait une connexion en train de
    réussir puis la déclarait « introuvable » 15 s après -> Joey croyait sa
    tête déconnectée
    - Chien vu pendant le t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
    [GeminiVision.kt, JoeyPrompt.kt, SpgGimbal.kt]
2026-10-22 v0.32 : plus de modèles de secours pour la vision (quotas gratuits séparés)
    Testé avec la clé : Robotics-ER, gemini-3-flash-preview, 3.5/3.1-flash-lite,
    flash-lite-latest et Gemma 4 (31b, 26b) pointent tous juste sur une image
    et acceptent la réponse JSON imposée. Chacun a son propre quota gratuit :
    on passe au suivant quand l'un est épuisé (429, mis de côté jusqu'à l'heure
    donnée), surchargé (503, 2 min) ou refuse une option (400).
    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
2026-10-22 Installation automatique sur le téléphone par le PC (Wi-Fi)
    tools/auto-install : le PC toujours allumé surveille la branche toutes les
    2 min, compile chaque nouvelle version (clés dans ~/.config/joey/env, jamais
    dans le dépôt ; même clé de signature, donc mise à jour par-dessus) et
    l'installe sur le téléphone par le débogage sans fil (adb, découverte mDNS
    ou adresse fixe), puis relance Joey. Compile une fois par version, réessaie
    l'installation si le téléphone n'est pas joignable, notification ntfy
    facultative. setup.sh installe les outils Android sans Android Studio et un
    service systemd utilisateur. Guide en français (S10 sans fil, S8+ par USB
    une fois après chaque redém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
2026-10-22 v0.33 : corrections d'après le journal du 22/10 (20:12-20:19)
    - Suivi du visage qui oscillait de ±25° : les petits mouvements expressifs
    étaient comptés deux fois (dans la pose de l'image et dans la visée) ; la
    pose est maintenant prise au moment de l'image (historique 40 ms, ~80 ms
    de retard) et sans ces mouvements ; vitesse un peu plus douce près du but
    - Résultat périmé d'une recherche (« pas trouvé le chien ») dit au milieu de
    la recherche suivante : plus livré si une autre demande est arrivée
    - « Chien » : seulement la catégorie chien du détecteur (mouton, ours, chat
    donnaient de fausses alertes)
    - Souvenirs : l'état passager du corps (nacelle connectée, r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
    [JoeyPrompt.kt]
2026-10-22 v0.34-0.35 : recherche en un seul tour, résultat tout de suite ; deux micros en conversation
    Recherche (d'après le journal : chien trouvé à 20:15:01, annoncé 6 s plus
    tard, la tête repartie chercher qui parlait) :
    - Un seul tour : à chaque arrêt, le détecteur du téléphone regarde (0,45 s)
    et l'image part à Gemini en parallèle ; le premier qui trouve gagne
    (avant : un tour au détecteur puis un tour Gemini). Une fausse alerte du
    détecteur ne l'arrête plus, il continue.
    - Trouvé : la tête se centre dessus et y reste 8 s (pas de recherche de qui
    parle pendant ce temps) ; le résultat est dit tout de suite (on n'attend
    plus un long silence, seulement qu'il ait fini sa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
2026-10-22 v0.36 : corrections d'après le journal du 22/10 (22:08-22:24)
    - Visages : il refuse d'enregistrer un visage déjà connu sous un autre
    prénom (le journal montre Michael reconnu comme « Johanna ») ; pour
    apprendre, il se tourne d'abord vers la personne ; « c'est qui ? » ->
    outil etat, qui donne maintenant les visages visibles et reconnus
    - « Regarde Michael » : plus de demi-tour vers un vieil endroit quand
    quelqu'un est déjà devant lui (« tu tournes trop »)
    - « Regarder ce que je montre » appelé 4 fois en boucle sans demande : seulement
    sur demande claire ; sans doigt pointé, il dit ce que la personne tient ou
    montre à la caméra (écran, papier, texte lu)
    - Visio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
    [GeminiVision.kt, JoeyPrompt.kt]
2026-10-22 v0.37 : moins de fantômes, visages fiables, tête calme, mémoire propre, prêt pour les roues
    1. Bruit pris pour de la parole (journal : « 今 お 金 に ね », « مثلا »…) :
    français imposé à Gemini Live (voix et transcription) ; un tour qui
    n'est que du bruit ne compte pas comme quelqu'un qui parle, et la réponse
    de Joey à ce bruit est coupée ; consigne de ne pas répondre au bruit
    2. Visages : complétés tout seuls quand il reconnaît quelqu'un avec
    certitude (≥ 0,62, toutes les 30 s) ; prénom affiché sous ses yeux
    3. Tête calme : écarts < 5° ignorés, rattrapage doux, mouvements expressifs
    atténués pendant le suivi ; « nervosité » mesurée da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
2026-10-22 v0.38 : écran épuré, visage plus grand
    - Commandes cachées par défaut ; un appui les montre, elles se cachent seules
    après 6 s (sauf panneau ou réglages ouverts)
    - Barre d'état réduite à des icônes (nacelle + batterie, conversation) sur
    fond très transparent ; boutons plus petits et translucides
    - Seul signe permanent : une petite girafe pâle quand la nacelle n'est pas
    connectée (un appui ouvre le panneau)
    - Yeux ~13 % plus grands
    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
2026-10-22 v0.39 : corrections d'après le journal du S8+ (23/10, 00:08-00:23)
    - Deux Joey en même temps (séances qui se chevauchent) : à la fermeture de
    l'app, le cerveau continuait (boucles de vie et de visée, envoi du
    journal) et relançait même l'écoute du mot de réveil -> deux écoutes se
    disputaient le micro. Tout s'arrête maintenant à la fermeture ; une seule
    fenêtre de Joey à la fois (singleTask).
    - « Un bruit toutes les 2 s » : l'écoute de « Joey » redémarrait toutes les
    1,5 s (micro occupé), avec son bip ; attente croissante (jusqu'à 30 s),
    et le journal ne répète plus « Mot de réveil actif »
    - Plein écran sur Android 9 (ancien mode immersif, remis au reto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
    [SpgGimbal.kt]
2026-10-22 v0.40 : mémoire partagée entre les téléphones (souvenirs et visages)
    - Tables souvenirs et visages dans le projet Supabase « joey », protégées par
    le code du foyer (en-tête x-joey-foyer, empreinte sha256 dans les lignes,
    RLS) : sans le code, ni lecture ni écriture (vérifié)
    - brain/SharedMemory : reçoit d'abord ce qui a changé ailleurs, puis envoie
    ce qui a changé ici ; au démarrage, toutes les 5 min et 15 s après un
    changement ; oublis (souvenirs, visages) propagés ; visages réunis sans
    doublons (40 empreintes au plus) ; pas de doublon de souvenir
    - Souvenirs avec identifiant stable ; suivi de ce qui reste à envoyer
    - Code du foyer injecté à la compilation (J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
2026-10-23 v0.41 : déplacements plus justes et réponses plus rapides (journal du S10, 23/10 16:03)
    - Viens ici / suis-moi / aller vers : l'angle de la tête par rapport au corps
    vient maintenant des roues (odométrie) et d'un repère pris en recentrant la
    tête. Avant, Joey prenait l'angle « monde » de la tête (ex. 169°) pour
    l'angle par rapport au corps et faisait demi-tour au lieu d'approcher.
    - Outils longs : réponse rapide attendue 0,4 s au lieu de 1,5 s.
    - Avancer / tourner : Joey dit « j'avance » pendant qu'il roule ; il n'est
    prévenu ensuite qu'en cas de problème. Les déplacements s'enchaînent dans
    l'ordre, « arrête » annule ceux en attente.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
2026-10-23 v0.42 : pilotage à la manette (Xbox…) et aspiration
    - Stick gauche : rouler (gâchette RT = plus vite, jusqu'à 0,5 m/s) ; stick
    droit : la tête ; A : aspiration marche/arrêt (brosses + aspirateur) ;
    B : tout arrêter ; Y : tête droite devant ; X : parler ; LB : base.
    - Les boutons sont pris avant l'écran (sinon B fermait l'app).
    - Toucher la manette reprend la main sur ce qu'il faisait tout seul.
    - « etat » dit si l'aspiration tourne ; un arrêt de sécurité la coupe.
    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
2026-10-23 Manette : pas de « -0 » pour la tête au repos
    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
2026-10-23 v0.43 : sans nacelle il tourne le corps, et corrections du journal (23/10 16:51)
    - Sans nacelle : « viens ici » et « chercher » tournent tout le corps par
    huitièmes de tour pour trouver la personne (ou le chien…), puis s'approchent.
    - Suis-moi : il avance tant que la silhouette est petite et ne recule que si on
    est tout contre lui (il reculait dès 2 m : « mauvais sens »).
    - « Fais un tour sur toi-même » (360°) : il ne tournait pas du tout.
    - Plus de faux « vide détecté » à l'arrêt : le mode sécurité du Roomba gère le
    vide, et l'arrêt est expliqué s'il arrive en route.
    - Ses propres roues ne déclenchent plus « on me secoue / on me soulève ».
    - Réglage « vi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
    [RoombaRobotTest.kt, SpgGimbal.kt]
2026-10-23 v0.44 : suivre et venir en douceur, avec ou sans nacelle
    - « Suis-moi » et « viens ici » partagent un même pilotage, toutes les 0,1 s :
    sans nacelle les roues font le cou (il tourne le corps vers la personne),
    avec nacelle le corps suit la tête.
    - Ordres lissés (plus d'avance-recule « en tremblant »), et ce que le corps a
    déjà tourné depuis l'image est retiré (il dépassait la cible puis repartait
    dans l'autre sens).
    - Perdue : il ralentit, puis tourne doucement du côté où il l'a vue.
    - La manette interrompt aussi « viens ici » / « va vers » en cours.
    Claude-Session: https://claude.ai/code/session_012MrQctv3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
2026-10-23 v0.45 : sans nacelle, il se débrouille avec ses roues
    Partout où il tournait la tête, il tourne le corps si la nacelle manque :
    cartographier (tour sur lui-même en 6 arrêts), aller vers (recherche en
    tournant), regarder gauche/droite/derrière, regarder autour (4 arrêts),
    se tourner vers quelqu'un, danser (il se dandine). « Ce que je montre » :
    il décrit ce qu'il a devant lui. Le prompt lui dit de ne pas déclarer
    « impossible sans la nacelle ».
    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
2026-10-23 v0.46 : Joey apprend de ce qu'on lui dit
    - Réglages qu'il ajuste lui-même (outil « ajuster ») : vitesse, proximité
    quand il suit/vient, vivacité des virages, correction des angles, sens des
    roues. Gardés pour toujours, bornés.
    - Auto-test des roues (« tester_roues ») : il compare deux images avant/après
    30 cm « en avant » (la scène grossit ou rapetisse) et inverse tout seul le
    sens si son visage regarde vers l'arrière du Roomba ; sans nacelle, il mesure
    ses quarts de tour avec les capteurs du téléphone et corrige l'odométrie.
    - Règles de conduite apprises (« retenir_regle » / « oublier_regle »),
    remises au début de chaque conversation.
    - « demander_amelio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
    [JoeyPrompt.kt]
2026-10-23 v0.47 : la tête n'entortille plus le câble du Roomba
    - On compte de combien la tête a tourné par rapport au corps (capteurs du
    téléphone + cap des roues, 10 fois par seconde), sans repli à ±180°.
    - Jamais plus d'un demi-tour (185°) de chaque côté : pour aller plus loin,
    la tête repart par l'autre côté (regarder, suivre, chercher, manette).
    - Tour complet de recherche : d'un bord à l'autre (deux demi-tours), plus
    jamais un tour de plus dans le même sens.
    - « etat » donne de combien la tête est tournée.
    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
2026-10-23 v0.48 : la personnalité de Joey (Beneath a Steel Sky), une voix grave, le babil du Roomba
    - Personnalité réécrite d'après le Joey du jeu : sarcastique, vaniteux, ironie
    britannique, loyal à Michael (son « Foster »), obsédé par la dignité de sa
    carcasse (un aspirateur !), un peu trouillard. Ses propres mots, pas de
    citations du jeu.
    - Voix grave par défaut (Charon ~130 Hz ; celle d'origine ~240 Hz, mesurée) ;
    choix dans les réglages ou à la voix (outil « changer_voix »), testé sur les
    trois modèles Live.
    - Babil : pendant qu'il parle, le Roomba bipe au rythme et à la hauteur de sa
    voix (réglage pour le couper).
    - Le prompt parle du demi-tour de tête (câble),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
2026-10-23 v0.49 : il contrôle mieux ses roues et se dégage quand il est coincé
    D'après le journal du 23/10 (20:36) :
    - Le babil réécrivait une mélodie dans le Roomba à chaque bip : le Roomba ne
    répondait plus pendant que Joey parlait (coupures à 18:42, 18:43, 18:47).
    Les deux syllabes sont maintenant enregistrées une fois, puis seulement jouées
    (au plus 3 par seconde).
    - Plus jamais à l'aveugle : sans réponse du Roomba depuis 0,7 s, les roues
    s'arrêtent (« recule de 2 m » avait roulé 43 s sans rien sentir) ; la liaison
    est cherchée aux autres vitesses ; Gemini est prévenu quand les roues se
    branchent, se coupent ou reviennent.
    - Un seul « suis-moi » à la fois (trois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
    [JoeyPrompt.kt, RoombaRobotTest.kt]
2026-10-23 v0.50 : le Roomba reste éveillé, et Joey va chercher ailleurs
    - Le Roomba s'endort au bout de 5 min en mode passif (et sans le fil de réveil,
    impossible de le rallumer) : au repos, Joey le remet en mode sécurité, où il
    ne s'endort pas (réglage pour le désactiver). En panne de réponse, « start »
    toutes les ~6 s pour reprendre dès qu'il est réveillé ; Gemini demande qu'on
    appuie sur CLEAN si ça dure.
    - Chercher : pas en vue autour de lui -> il part explorer (90 s) pour le trouver,
    avec ou sans nacelle, y compris une personne.
    - « Aller à » une pièce qui n'est pas sur la carte -> il part la chercher.
    - « Cartographie la maison » : il relève la pièce, explore, re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
2026-10-23 v0.51 : navigation autonome (carte en grille, trajets, exploration guidée, mode autonome)
    - NavGrid : carte en carreaux de 10 cm dans le repère des roues : libre là où il
    passe, occupé là où il touche (pare-chocs) ou voit un obstacle de près
    (détecteurs de proximité), interdit là où il sent un vide. Sur sa base, la
    base devient l'origine et la carte est gardée d'une fois sur l'autre (il se
    recale à chaque retour à la base).
    - Trajets : plus court chemin (A*) avec marge pour son corps ; il suit les
    segments, se dégage et recalcule s'il touche quelque chose. « aller_a » s'en
    sert ; nouvel outil « revenir » (retour au point de départ de la mission).
    - Exploratio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
2026-10-23 v0.52 (en cours) : mémoire des positions (objets, personnes), « aller_voir »
    - En cartographiant, chaque objet vu reçoit sa position sur la carte en grille
    (si la carte est gardée, repère = sa base) ; « aller_vers » y va d'abord par
    la carte quand c'est loin, puis s'approche à vue.
    - Chaque personne reconnue est placée sur la carte (distance d'après la taille
    du visage) ; outil « aller_voir » : en vue -> il y va ; sinon là où il l'a vue
    en dernier, puis il cherche ; sinon il explore.
    - Correction : un retour à la ligne cassait la consigne de guidage visuel.
    Claude-Session: https://claude.ai/code/session_012MrQct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
    [GeminiVision.kt, JoeyPrompt.kt]
2026-10-23 v0.52 : numéro de version
    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
2026-10-23 v0.53 : conduite fluide et vitesse modulée
    - followPath : il suit un trajet d'un mouvement continu, en courbes (point visé
    35 cm devant sur le trajet), au lieu de s'arrêter, pivoter et repartir à
    chaque virage ; il ne pivote sur place que pour un virage franc.
    - Vitesse modulée : jusqu'à 0,4 m/s (réglable 0,1-0,5) là où la carte voit la
    voie libre, plus prudent dans l'inconnu, dans les virages, près d'un
    obstacle et à l'arrivée ; accélérations et freinages progressifs.
    - Trajets (aller_a, revenir, aller_vers loin) et exploration utilisent cette
    conduite ; l'exploration roule plus loin entre deux regards (jusqu'à 2,5 m),
    vite quand la vision voit beaucoup de sol lib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
2026-10-23 v0.54 : il utilise tous les capteurs du Roomba
    - Lecture des autres capteurs de la série 600 quand le Roomba les accepte
    (sinon retour automatique aux capteurs de base, testé) : mur à droite, mur
    virtuel, surintensité des moteurs, saleté, balises infrarouges de la base,
    boutons, température de la batterie, intensité des 6 détecteurs de proximité.
    - Les détecteurs de proximité et le capteur de mur dessinent les obstacles sur
    la carte avant le contact et le font ralentir ; mur virtuel infranchissable.
    - Roues en surintensité = coincé (même quand elles patinent).
    - Boutons : CLEAN = aspiration, SPOT = il vient vers la personne, DOCK = base.
    - « etat » : base en vue, capt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
2026-10-23 v0.54 : numéro de version
    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
2026-10-23 v0.55 : il voit l'obstacle avant de le toucher
    - FloorVision (sur le téléphone, sans quota, ~6 fois par seconde) : il apprend
    l'apparence du sol en roulant sans rien toucher ; dans chaque colonne de
    l'image il cherche où le sol s'arrête, et la hauteur de la caméra et son
    inclinaison donnent la distance : place libre droit devant, et 16 directions.
    - Les roues s'en servent : il ralentit à l'approche et s'arrête avant le choc
    (« obstacle vu devant »), puis recalcule son chemin (trajets) ou part d'un
    autre côté (exploration), sans reculer.
    - La carte aussi : le sol vu est libre, son bord est un obstacle à confirmer
    (vu deux fois) ; trajets et exploration en tiennent comp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
2026-10-23 v0.55 : la tablette (voir, comprendre, piloter, parler)
    - Page https://<adresse du téléphone>:8443/tablette (même Wi-Fi) : ce qu'il voit
    en direct, ce qu'il pense (fil de son journal : ce qu'il entend, dit, les outils
    qu'il appelle et leurs résultats, ses décisions), son état (humeur, batteries,
    roues, nacelle, carte, place libre devant), sa carte (grille, pièces, objets,
    personnes, base, sa position), deux manettes tactiles (rouler, tête), les
    commandes (stop, viens ici, explorer, cartographier, base, aspiration, tête
    devant, autonome, dormir), et lui parler : micro de la tablette (sa voix sort
    de la tablette) ou en écrivant.
    - Le serveur démarre avec l'app (réglag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
2026-10-23 v0.56 : navigation testée dans un monde simulé
    - Navigator : la navigation sort du cerveau (carte tenue à jour par les
    passages, contacts, détecteurs de proximité et la caméra ; trajets avec
    dégagement et recalcul), pour pouvoir la tester sans téléphone.
    - Simulateur : le faux Roomba des tests cogne de vrais murs (pare-chocs sur ±40°,
    roues qui patinent). Deux tests : il contourne un canapé qu'il ne connaît pas
    en le découvrant au toucher ; avec une caméra, il le contourne sans le toucher.
    - Carte : marge autour des obstacles portée à 2 carreaux (son rayon est de
    17 cm : avec 1 carreau, ses trajets frôlaient les meubles).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
2026-10-23 v0.56 : pilote PC (Claude Code local), simulateur réussi, marges élargies
    - Pilote PC : tools/joey-pilot/joey.py (état, fil de pensée, parler, commandes,
    rouler, lancer n'importe quel outil et attendre son résultat, image, carte en
    texte) + CLAUDE.md (règles de sécurité, campagne de tests, rapport et
    demandes d'amélioration pour la nuit) + README. Outils protégés par un code
    pilote (journal et réglages) ; lecture de ~/.config/joey/env.
    - /tab/tool : le PC lance un outil comme Gemini le ferait (journalisé).
    - Simulateur : le défaut trouvé (avec la caméra, il touchait le canapé 4 fois,
    puis restait bloqué devant son angle) est corrigé : bords d'obstacles vus
    trac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
2026-10-23 Pilote PC : sans code, ouvert sur le Wi-Fi de la maison (choix de Michael)
    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
2026-10-23 v0.57 : numéro de version (pilote sans code)
    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
2026-10-23 Navigation : exploration méthodique par les frontières (frontierStep)
    Il va vers la frontière (bord du connu) la plus proche vers laquelle un
    chemin existe, et écarte celles où il n'arrive pas. L'exploration sans
    vision Gemini s'en sert.
    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
2026-10-23 v0.58 : exploration validée dans un appartement simulé
    Test : deux pièces de 3 x 3 m, cloison avec porte de 80 cm, caméra simulée.
    Parti sans rien connaître, il trouve la porte et cartographie l'appartement
    (17,3 m² sur ~17) en 36 s, 3 pas d'exploration, aucun choc.
    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
2026-10-23 v0.59 : il contourne les vides (escaliers), visages envoyés moins souvent
    - Vide (marche, escalier) sur son trajet : au lieu d'abandonner, il recule, le
    note comme infranchissable (arc plus large et plus profond sur la carte), se
    tourne et recalcule ; il n'abandonne qu'après 8 vides. Testé dans le
    simulateur (trou de 80 x 80 cm entre lui et le but) : jamais au-dessus du
    vide, arrivé au but, puis revenu au départ par sa carte.
    - Le faux Roomba des tests : capteurs de vide à l'avant, et comme le vrai,
    reculer reste permis devant un vide.
    - Journal du 23/10 (v0.55) : le visage complet partait toutes les 30 s (complément
    automatique à chaque reconnaissance) : maintenant au pl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
    [RoombaRobotTest.kt]
2026-10-23 v0.60 : il rentre à sa base par sa carte
    Quand sa carte part de sa base (il y était au départ), « rentre à ta base »,
    la batterie faible, le bouton DOCK, la manette et le mode autonome le font
    d'abord revenir à 50 cm de la base par le plus court chemin, puis le Roomba
    accoste avec ses balises (avant : le Roomba cherchait seul, au hasard, ce qui
    est long ou raté si la base est dans une autre pièce). En arrière-plan pour
    Gemini (il peut parler pendant le trajet).
    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
2026-10-23 v0.61 : sans nacelle, le gyroscope du téléphone donne ses rotations
    Le téléphone fixé au corps mesure les virages bien mieux que les roues
    (qui patinent sur un tapis) : l'odométrie prend le cap du gyroscope quand
    il est disponible et cohérent, celui des roues sinon (nacelle, téléphone
    à plat). Test : roues mal réglées de 30 %, le quart de tour reste juste à 5°.
    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
    [RoombaRobotTest.kt]
2026-10-23 v0.62 : corrections de la première vraie séance avec le Roomba
    Journal du 23/10 (22h45-23h10, v0.58) :
    - La tête regarde la route pendant les trajets : la nacelle restait tournée
    ailleurs après chaque virage, la vision du sol se coupait, une vingtaine de
    chocs. Elle vise l'avant du corps, se recentre après chaque dégagement.
    - « Tu vas dans le mauvais sens » ne retourne plus les roues sans vérifier :
    auto-test à la caméra d'abord, sinon confirmation demandée.
    - Positions des pièces liées à leur repère (base ou séance) : le « salon »
    d'une autre séance l'envoyait au fond de la cuisine ; sinon il cherche.
    - Branché ailleurs que sur sa base : nouvelle carte (la pos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
    [JoeyPrompt.kt, RoombaRobotTest.kt]
2026-10-23 v0.63 : la tête sur la route, vérifiée au simulateur avec une nacelle réaliste
    Le regard « route » (v0.62) passe dans une classe à part (RoadGaze) et est
    testé dans un monde simulé où la nacelle est stabilisée (elle garde sa
    direction quand le corps tourne), tourne à 40°/s, et où la caméra ne voit
    le sol que si elle regarde dans l'axe du corps et vers le bas.
    Contourner un canapé : tête fixe (comme la v0.58) 2 à 5 chocs ; tête sur
    la route : 0 choc, caméra utile 4 à 5 fois plus souvent. Sortir d'un coin
    en L : arrivé, 0 à 1 contact.
    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
2026-10-23 v0.64 : la nacelle mieux trouvée (S8), et le journal dit ce qui bloque
    Le S8 (Android 9) n'a jamais trouvé la nacelle (22/10 et 23/10), alors que
    le S10 s'y connecte. Maintenant :
    - nacelle déjà appairée au téléphone : connexion directe ;
    - reconnue aussi à son service série (6e400001…) si elle n'annonce pas son
    nom ;
    - sans l'autorisation « Position » (Android 9-11), on le dit clairement ;
    - recherche ratée : le journal liste les appareils Bluetooth vus (ou dit
    qu'il n'en voit aucun : recherche bloquée par Android).
    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
    [SpgGimbal.kt]
2026-10-23 v0.65 : corrections de la première campagne de tests sur PC (24/10)
    - Pied de chaise heurté en ligne droite : la vision du sol (couleur) ne
    voit pas le bois clair sur le tapis crème (vérifié sur les vraies images).
    Pendant les trajets, le détecteur d'objets (chaises, tables, canapé,
    plantes, chien…) donne aussi la distance par le bas de sa boîte ; sans
    avis de la caméra, il roule à 0,2 m/s au lieu de 0,4.
    - « revenir » sans chemin après une exploration entre les chaises : là où
    son centre est passé, il peut repasser (plan de secours).
    - Repère tête-corps faux (-92° alors qu'elle regardait devant) : oublié
    quand on le soulève ou le pousse, repris par la vrai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
2026-10-23 v0.66 : Joey s'affiche par-dessus l'écran de verrouillage
    - Relancé par l'installation automatique la nuit, écran éteint et
    verrouillé, il restait derrière la veille et ne répondait plus au PC
    (24/10, 01:27). Il s'affiche maintenant par-dessus le verrouillage et
    rallume l'écran ; le reste du téléphone reste verrouillé.
    - Installation automatique : réveille l'écran avant de relancer Joey.
    - Matériel : ne pas alimenter le téléphone par les broches 1 et 2 de la
    prise du Roomba (fusible de 200 mA) ; se brancher sur la batterie.
    Claude-Session: https://claude.ai/code/session_01CJmMrCjeW1NLMeaDL913m1
2026-10-24 v0.67 : une carte plus fine, qui ne ferme plus les passages entre les chaises
    - Carreaux de 5 cm (au lieu de 10) ; marge exacte autour des obstacles :
    interdit à moins de son rayon + 3 cm, puis un coût qui décroît sur 20 cm
    (il passe au milieu). Avant, tout passage de moins de ~55 cm était fermé
    (24/10 : 48 cm entre deux chaises, « pas de chemin »).
    - Les raccourcis du chemin ne passent jamais plus près des obstacles que
    le chemin qu'ils remplacent (les lignes droites frôlaient les coins).
    - La caméra efface peu à peu un obstacle vu qui n'est plus là ; un
    obstacle touché plusieurs fois reste. Rayons de vue avec une largeur
    (plus d'inconnu entre deux rayons), sans d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
    [RoombaRobotTest.kt]
2026-10-24 v0.68 : un chef d'orchestre pour le mode autonome, et des accostages vérifiés
    - Règle d'autonomie unique (life/AutonomyPolicy, testée seule), par ordre
    de priorité : se recharger (batterie des roues < 25 %, du téléphone
    < 20 %, ou la nuit), saluer qui arrive, se reposer en charge jusqu'à
    80 %, explorer par séances de 3 min tant que la carte a des frontières,
    puis une petite ronde par heure. Remplace l'ancienne boucle (exploration
    de 75 s toutes les 30 min, sans fin).
    - Accostage vérifié : il attend d'être vraiment sur sa base (5 min au
    plus) ; raté, il recule, se retourne et réessaie ; raté encore, il
    prévient (ntfy) et attend 5, 15, 45 min… avant de retenter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
2026-10-24 v0.69 : profondeur MiDaS, pièces, recalcul du chemin en route, relancement au démarrage
    - Profondeur par réseau sur le téléphone (MiDaS v2.1 small, licence MIT) :
    pendant les trajets, 3 à 4 fois par seconde ; le plan du sol est ajusté
    sur la carte de profondeur, ce qui en dépasse est un obstacle, et sa
    distance vient de sa propre profondeur (prudente). Validé sur les images
    du 24/10 : pied de chaise à ~0,38 m (la couleur du sol disait « libre »),
    canapé à ~0,4-0,5 m. La garde d'obstacles prend la plus prudente de la
    couleur du sol, du détecteur d'objets et de la profondeur.
    « cmd profondeur on=0 » la coupe.
    - Recalcul du chemin en route (comme Nav2) : si un obs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
2026-10-24 v0.70 : le retour à la base vise le bon côté
    Le Roomba accoste en avançant : sur sa base il lui fait face, et il la
    quitte en reculant (x négatifs sur la carte quand Joey regarde vers
    l'avant du Roomba, ce qui est son montage : le 24/10, le pare-chocs
    touchait du côté de la caméra). Le retour par la carte visait toujours
    +0,5 m, c'est-à-dire derrière la base, contre le mur. Le point
    d'approche suit maintenant le sens de montage (Navigator.dockApproach) ;
    test : sorti de la base, il est du côté du point d'approche, dans les
    deux montages.
    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
2026-10-24 v0.71 : Joey reste joignable écran éteint
    - 24/10 : écran éteint et verrouillé, le S8+ coupait son Wi-Fi ; Joey ne
    répondait plus au PC et la mise à jour attendait. Tant que Joey tourne,
    le processeur et le Wi-Fi restent éveillés ; relâchés sous 15 % de
    batterie (le téléphone n'est pas alimenté).
    - Installation automatique : exempte Joey de la mise en veille profonde
    d'Android (sinon ces réglages sont ignorés quand le téléphone dort).
    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
2026-10-24 v0.72 : pastilles du corps, tours d'horizon cartographiques, reprise de contrôle du Roomba
    Séance du 24/10 (midi) :
    - Le recentrage de la nacelle ne remet pas la tête dans l'axe du Roomba
    (+30°, -15°, -64° selon les fois) et la nacelle, verrouillée, ne suit
    pas le corps. Deux pastilles blanches collées dans l'axe du Roomba :
    tête baissée, Joey mesure l'angle tête-corps (point de fuite de l'axe,
    senses/BodyMarks, testé sur 6 images de la séance) et remet la tête
    dans l'axe avant chaque trajet et pour « tête droit devant ». Une
    flèche imprimée (hardware/repere-corps) prendra le relais (cmd fleche).
    - Tour d'horizon cartographique (cmd scan) : 12 images de profond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
    [fleche.scad, fleche.stl]
2026-10-24 v0.73 : recalage de la tête par les pastilles, amorti et journalisé
    - 13:37 : après le recalage, la tête était à +59° de l'axe (dernière
    mesure -58°, trois essais seulement, sans détail). Rejouée depuis le
    PC, la boucle converge en oscillant (14° -> -11° -> 6°) : la nacelle
    dépasse la cible sur les petits angles. Désormais 5 essais, correction
    amortie à 80 %, arrêt sous 5°, une ligne de journal par essai.
    - Le compteur du câble de la nacelle se recale sur l'angle réel mesuré
    par les pastilles (au tour près) : il dérivait.
    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
2026-10-24 v0.74 : connexion au Roomba journalisée et réessayée
    Après la mise à jour de 13:45, le Roomba n'était plus connecté et le
    journal ne disait rien : au démarrage, la connexion se fait en silence
    et n'était jamais réessayée. Chaque échec va maintenant au journal (une
    fois par cause), et sans roues Joey réessaie toutes les 30 s.
    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
2026-10-24 v0.75 : recalage de la tête par les pastilles, correction tête relevée
    Tête très baissée, la nacelle dépassait sa cible de 2 à 3 fois et la
    boucle oscillait (24/10, 13:57 : -18°, -70°, +38°, -36°, +39°). La
    mesure se fait tête baissée, la correction tête relevée, amortie à 60 %.
    La carte USB du Roomba était réglée sur 3,3 V (le Roomba attend 5 V) :
    passée en 5 V, la liaison tient (342 lectures en 30 s sans coupure).
    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
2026-10-24 v0.76 : le corps se tourne vers la tête, boutons du Roomba filtrés
    - Recalage par les pastilles : c'est le corps qui tourne (le Roomba tourne
    juste, la nacelle verrouillée garde la tête fixe dans la pièce). Tourner
    la tête vers le corps oscillait (-80° -> -40° -> +37°).
    - Boutons du Roomba : un appui compte s'il est lu deux fois de suite, pas
    dans les 5 s après une reconnexion, et jamais en mode test (24/10 : CLEAN
    pour réveiller le Roomba et un DOCK fantôme ont lancé l'aspiration et la
    recherche de la base).
    - Connexion : essaie aussi 19 200 bauds.
    - « regarder devant » : 45 s au plus (le recalage dépassait 15 s).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
2026-10-24 v0.77 : pastilles cherchées en tournant le corps, liaison rouverte après 8 s
    - Pastilles invisibles (tête loin sur le côté : 24/10, -64°, hors de
    l'image) : le corps tourne de 60° et Joey regarde de nouveau (5 fois au
    plus) ; le journal dit l'inclinaison, le nombre de taches et la taille
    de l'image.
    - La réouverture automatique de la carte USB a marché (14:16) : délai
    ramené de 20 à 8 s. (La liaison saute à chaque départ de la base.)
    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
2026-10-24 v0.78 : yeux pixelisés (cmd pixels), il lève les yeux vers qui touche l'écran
    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
2026-10-24 v0.79 : sortie de base vérifiée (start renvoyé, repli par CLEAN), cmd sortie et firmware
    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
2026-10-24 v0.80 : mode du Roomba annoncé avec un cran de plus (cause des coupures à la sortie de base), impulsion de réveil de 1 s
    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
2026-10-24 v0.81 : alignement borné (plus de recherche après une mesure, 240° au plus), faisceau de la base ignoré comme mur virtuel, faux bouton DOCK, pas de double installation
    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
2026-10-24 v0.82 : pastilles reconnues par leur forme (S10, caméra décalée), test du fil de réveil (cmd brc), pas de mélodie en roulant
    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
2026-10-24 v0.83 : relecture (capteurs lus par groupe sans l'octet 7 reset, mur virtuel 162, mélodies limitées, réveil hors de la boucle, recul arrêtable, recherche des pastilles par la tête, script d'installat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
    [RoombaRobotTest.kt]
2026-10-24 Rapport de séance du 24/10 après-midi
    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
2026-10-24 v0.84 : sortie de base par CLEAN si les roues ne tournent pas en mode complet, test du fil de réveil après le redémarrage, cmd cable, cmd oi (octets bruts)
    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
2026-10-24 v0.85 : bips de la reconnaissance vocale coupés (volume des notifications), pas d'écoute ni de mouvements de tête en mode test, câble protégé pendant l'alignement, plus de replis inventés, nacelle en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
2026-10-24 v0.87 : demi-tour quand il est bloqué de face ou au troisième essai, pare-chocs gauche/droite dans le faux Roomba
    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
2026-10-24 v0.89 : zéro du câble à la connexion de la nacelle, la tête suit le corps pendant l'accostage et les trajets sans repère, recherche des pastilles guidée par le câble
    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
2026-10-24 Flèche d'orientation v2 (STL, 60 × 24 mm, d'un seul tenant)
    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
    [fleche_v2.stl]
2026-10-24 Anneau d'orientation en quatre quarts (symbole différent à chaque point cardinal)
    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
    [anneau-quart-arriere.stl, anneau-quart-avant.stl, anneau-quart-droite.stl, anneau-quart-gauche.stl]
2026-10-24 v0.90 : sortie de base, redémarrage du Roomba en dernier recours (moteurs coupés après la charge)
    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
2026-10-24 Anneau d'orientation d'un seul tenant (Ø 228 mm, Centauri Carbon 2)
    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
    [anneau-quart-arriere.stl, anneau-quart-avant.stl, anneau-quart-droite.stl, anneau-quart-gauche.stl, anneau.stl]
2026-10-24 v0.91 : redémarrage volontaire du Roomba sans fausse alerte de liaison (sortie de base validée après redémarrage)
    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
2026-10-24 v0.92 : détecteur de l'anneau d'orientation (cmd anneau on=1), caméra ralentie à l'arrêt en mode test
    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
2026-10-24 Rapport de la soirée du 24/10 et lancement automatique des séries
    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
2026-10-24 v0.93 : à 6 % de batterie du téléphone, roues arrêtées et mode passif (le Roomba ne garde pas son dernier ordre)
    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
2026-10-24 v0.94 : pas de vide noté roues soulevées, nacelle inerte détectée (déroulement suspendu), garde-fou qui attend 15 s
    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
2026-10-24 v0.95-0.96 : écran rallumé si la caméra ne voit plus rien (et au démarrage), demi-tour dans le sens qui déroule le câble
    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
2026-10-24 v0.97 : accostage en pause quand le câble se tord (la tête rattrape le corps), pas de recalcul sans fin du même chemin
    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
2026-10-24 Rapport : série de 20 h 15
    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
